faredoonhdastur/Fin-Controlled-Rocket/pics/IMG_1974.jpg

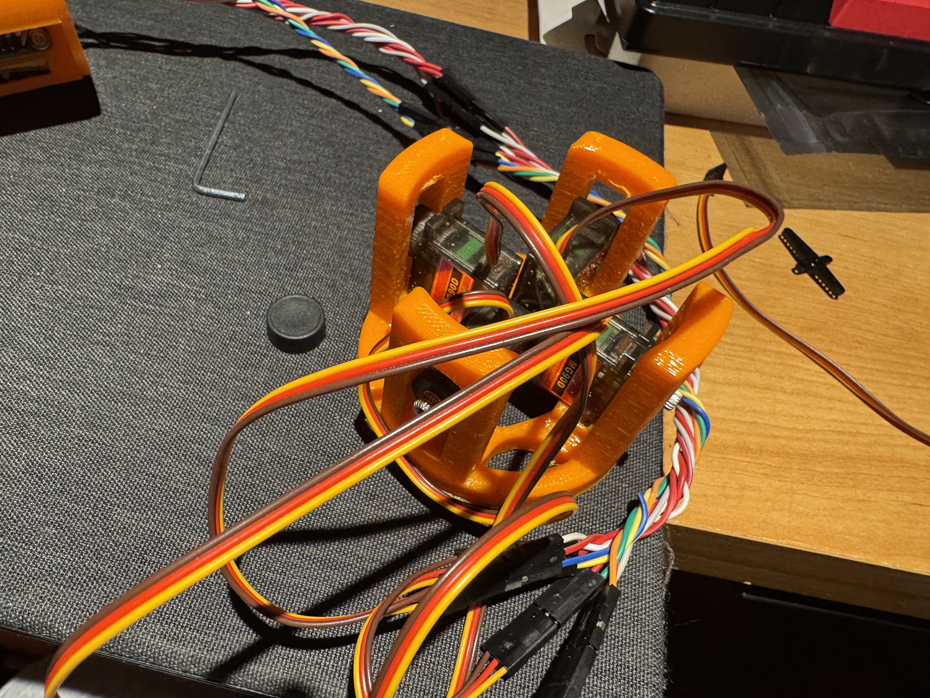
pics/IMG_1974.jpg
