faredoonhdastur/Fin-Controlled-Rocket/pics/IMG_1976.jpg

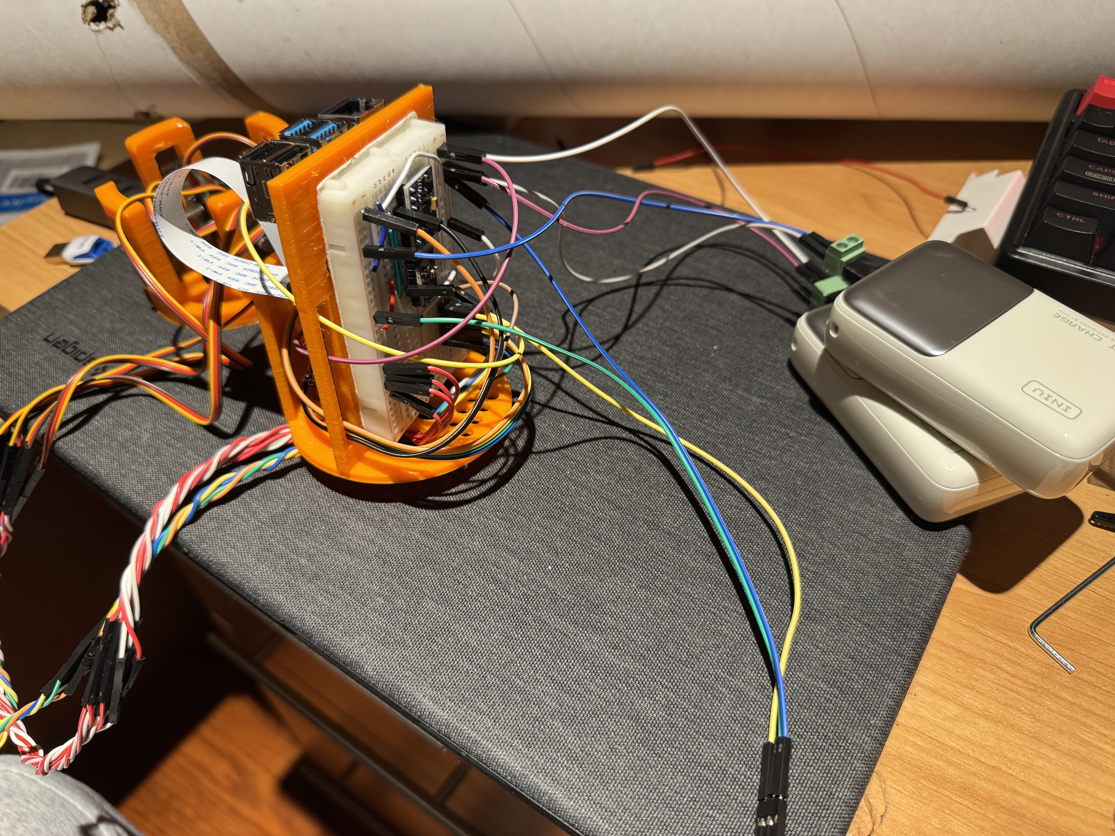
pics/IMG_1976.jpg
