faredoonhdastur/Fin-Controlled-Rocket/pics/IMG_1977.jpg

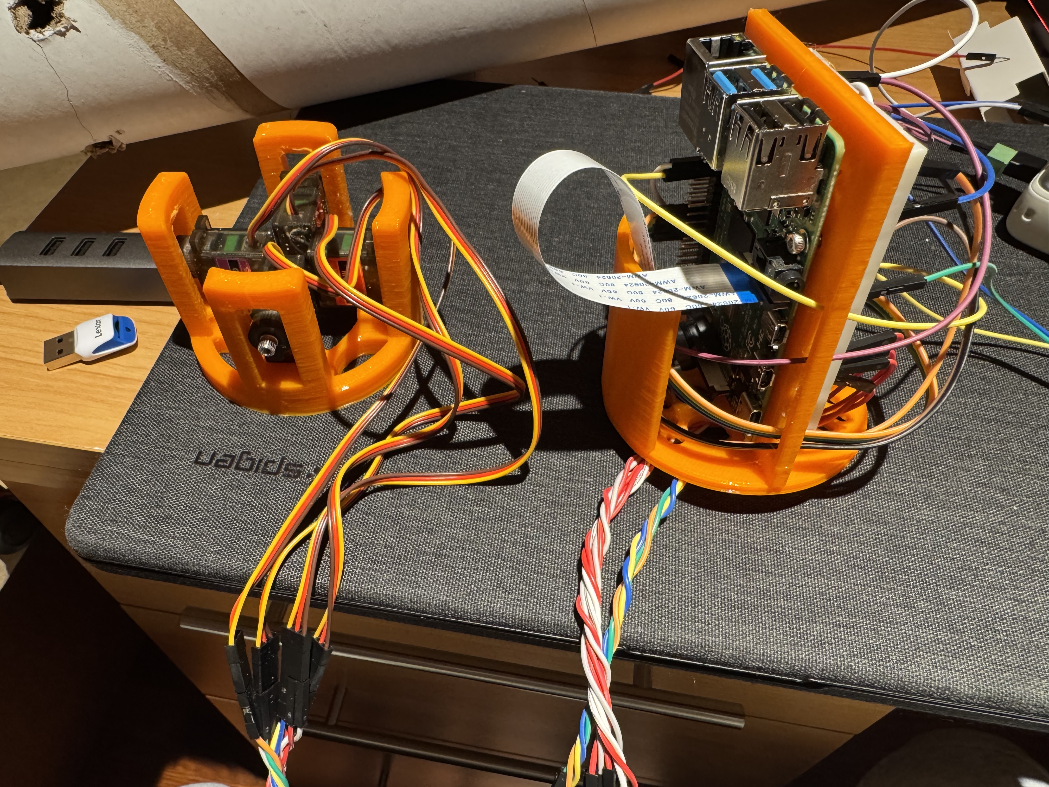
pics/IMG_1977.jpg
