faredoonhdastur/Fin-Controlled-Rocket/3d_models/nosecone_cover.stl

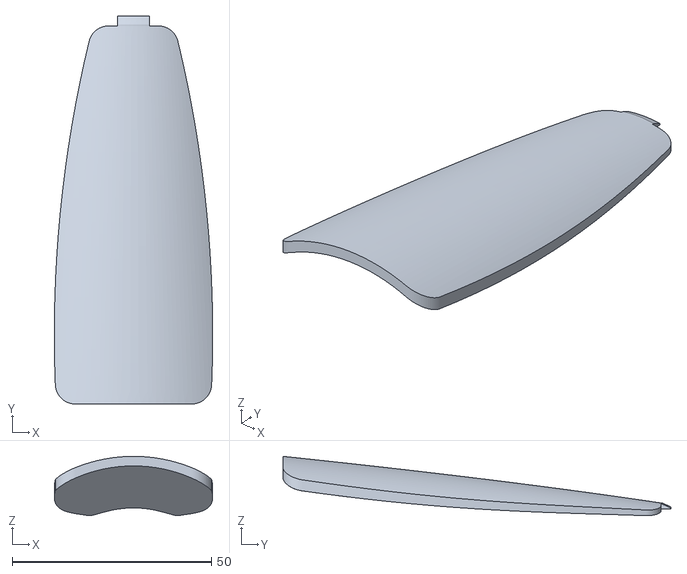
[picture p5: CAD file, 2026-11-11]
3d_models/nosecone_cover.stl
39.7 x 97.3 x 14.9
