faredoonhdastur/Fin-Controlled-Rocket/3d_models/fin_mounting_bracket.stl

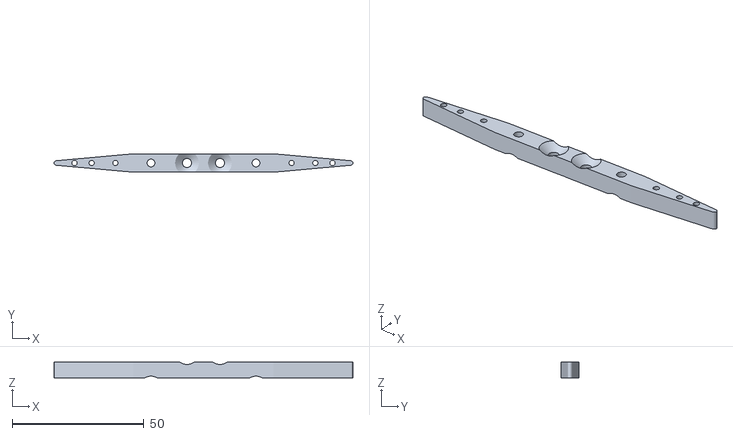
[picture p6: CAD file, 2026-11-11]
3d_models/fin_mounting_bracket.stl
113.3 x 7.00 x 6.00
