faredoonhdastur/Fin-Controlled-Rocket/3d_models/fins_mount.stl

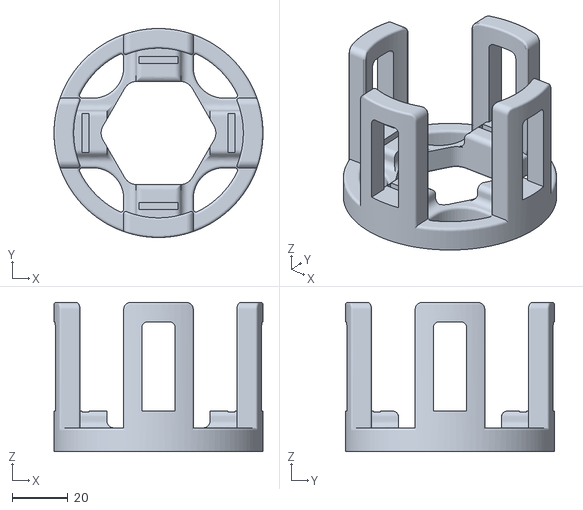
[picture p7: CAD file, 2026-11-11]
3d_models/fins_mount.stl
75.0 x 75.0 x 53.5
