faredoonhdastur/Fin-Controlled-Rocket/3d_models/battery_holder.stl

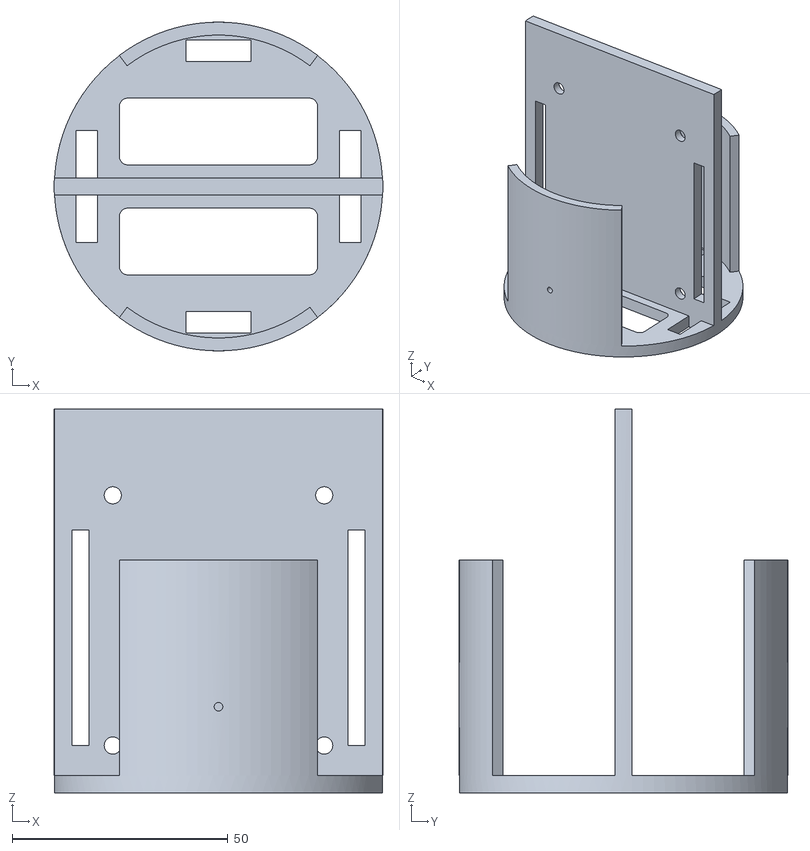
[picture p8: CAD file, 2026-11-11]
3d_models/battery_holder.stl
76.2 x 76.2 x 89.0
