faredoonhdastur/Fin-Controlled-Rocket/3d_models/motor_holder.stl

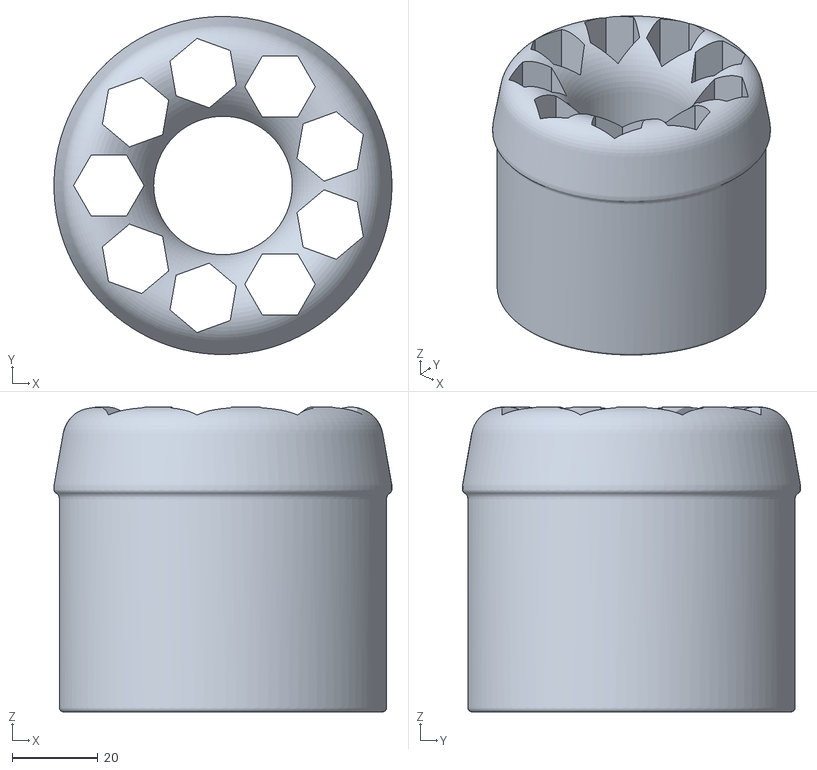
[picture p9: CAD file, 2026-11-11]
3d_models/motor_holder.stl
78.7 x 78.7 x 71.0
