faredoonhdastur/Fin-Controlled-Rocket/3d_models/avionics_housing.stl

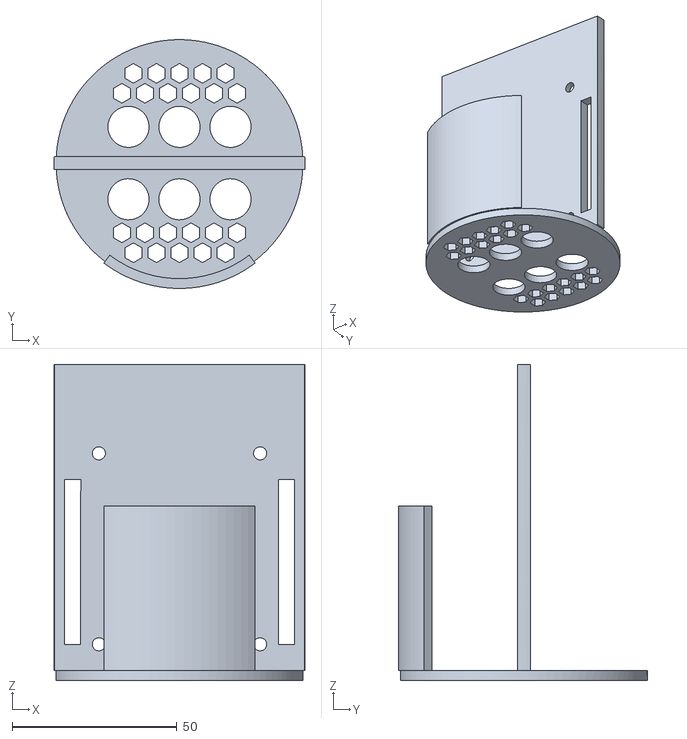
[picture p10: CAD file, 2026-11-11]
3d_models/avionics_housing.stl
76.2 x 75.6 x 96.0
