faredoonhdastur/Fin-Controlled-Rocket/3d_models/fin.stl

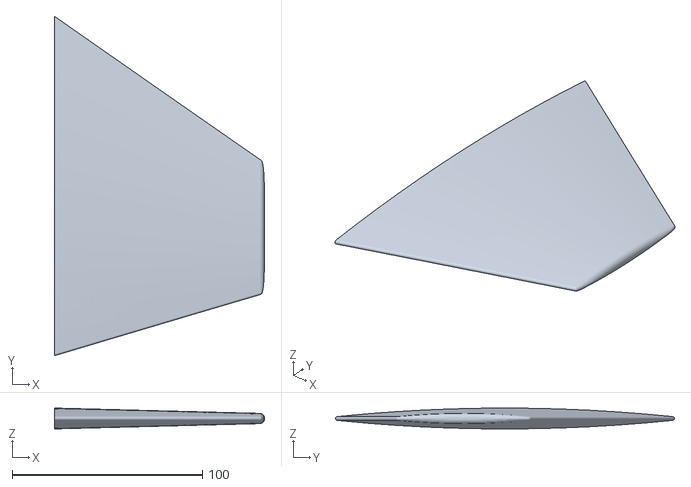
[picture p11: CAD file, 2026-11-11]
3d_models/fin.stl
110.5 x 178.6 x 11.0
