faredoonhdastur/Fin-Controlled-Rocket/3d_models/nosecone.stl

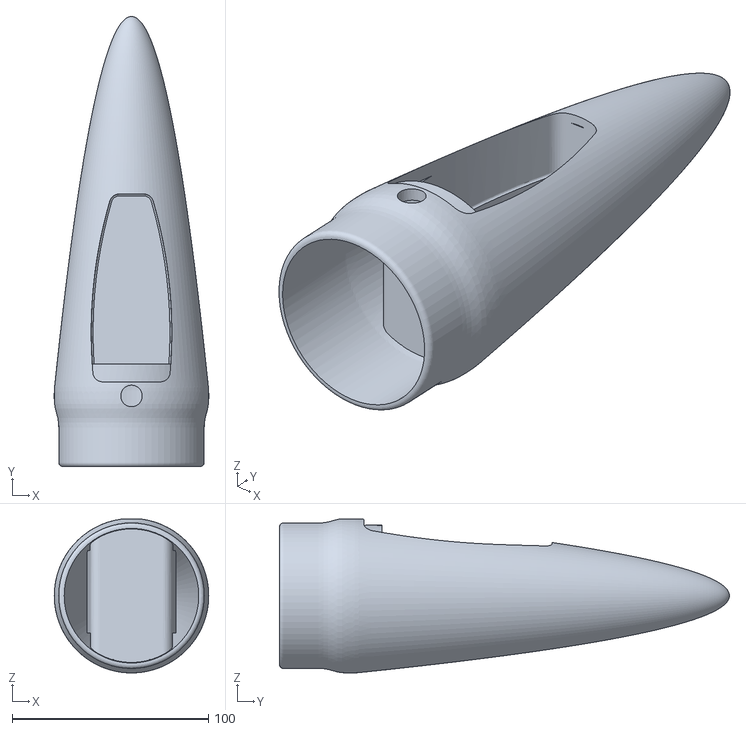
[picture p12: CAD file, 2026-11-11]
3d_models/nosecone.stl
78.8 x 229.5 x 78.5
